xingrz/DeerMon-PCB/documents/ESP32-PICO-V3-02/SCH_ESP32-PICO-KIT-1_V1_0_20200811A.pdf

# ESP32

# Power Supply

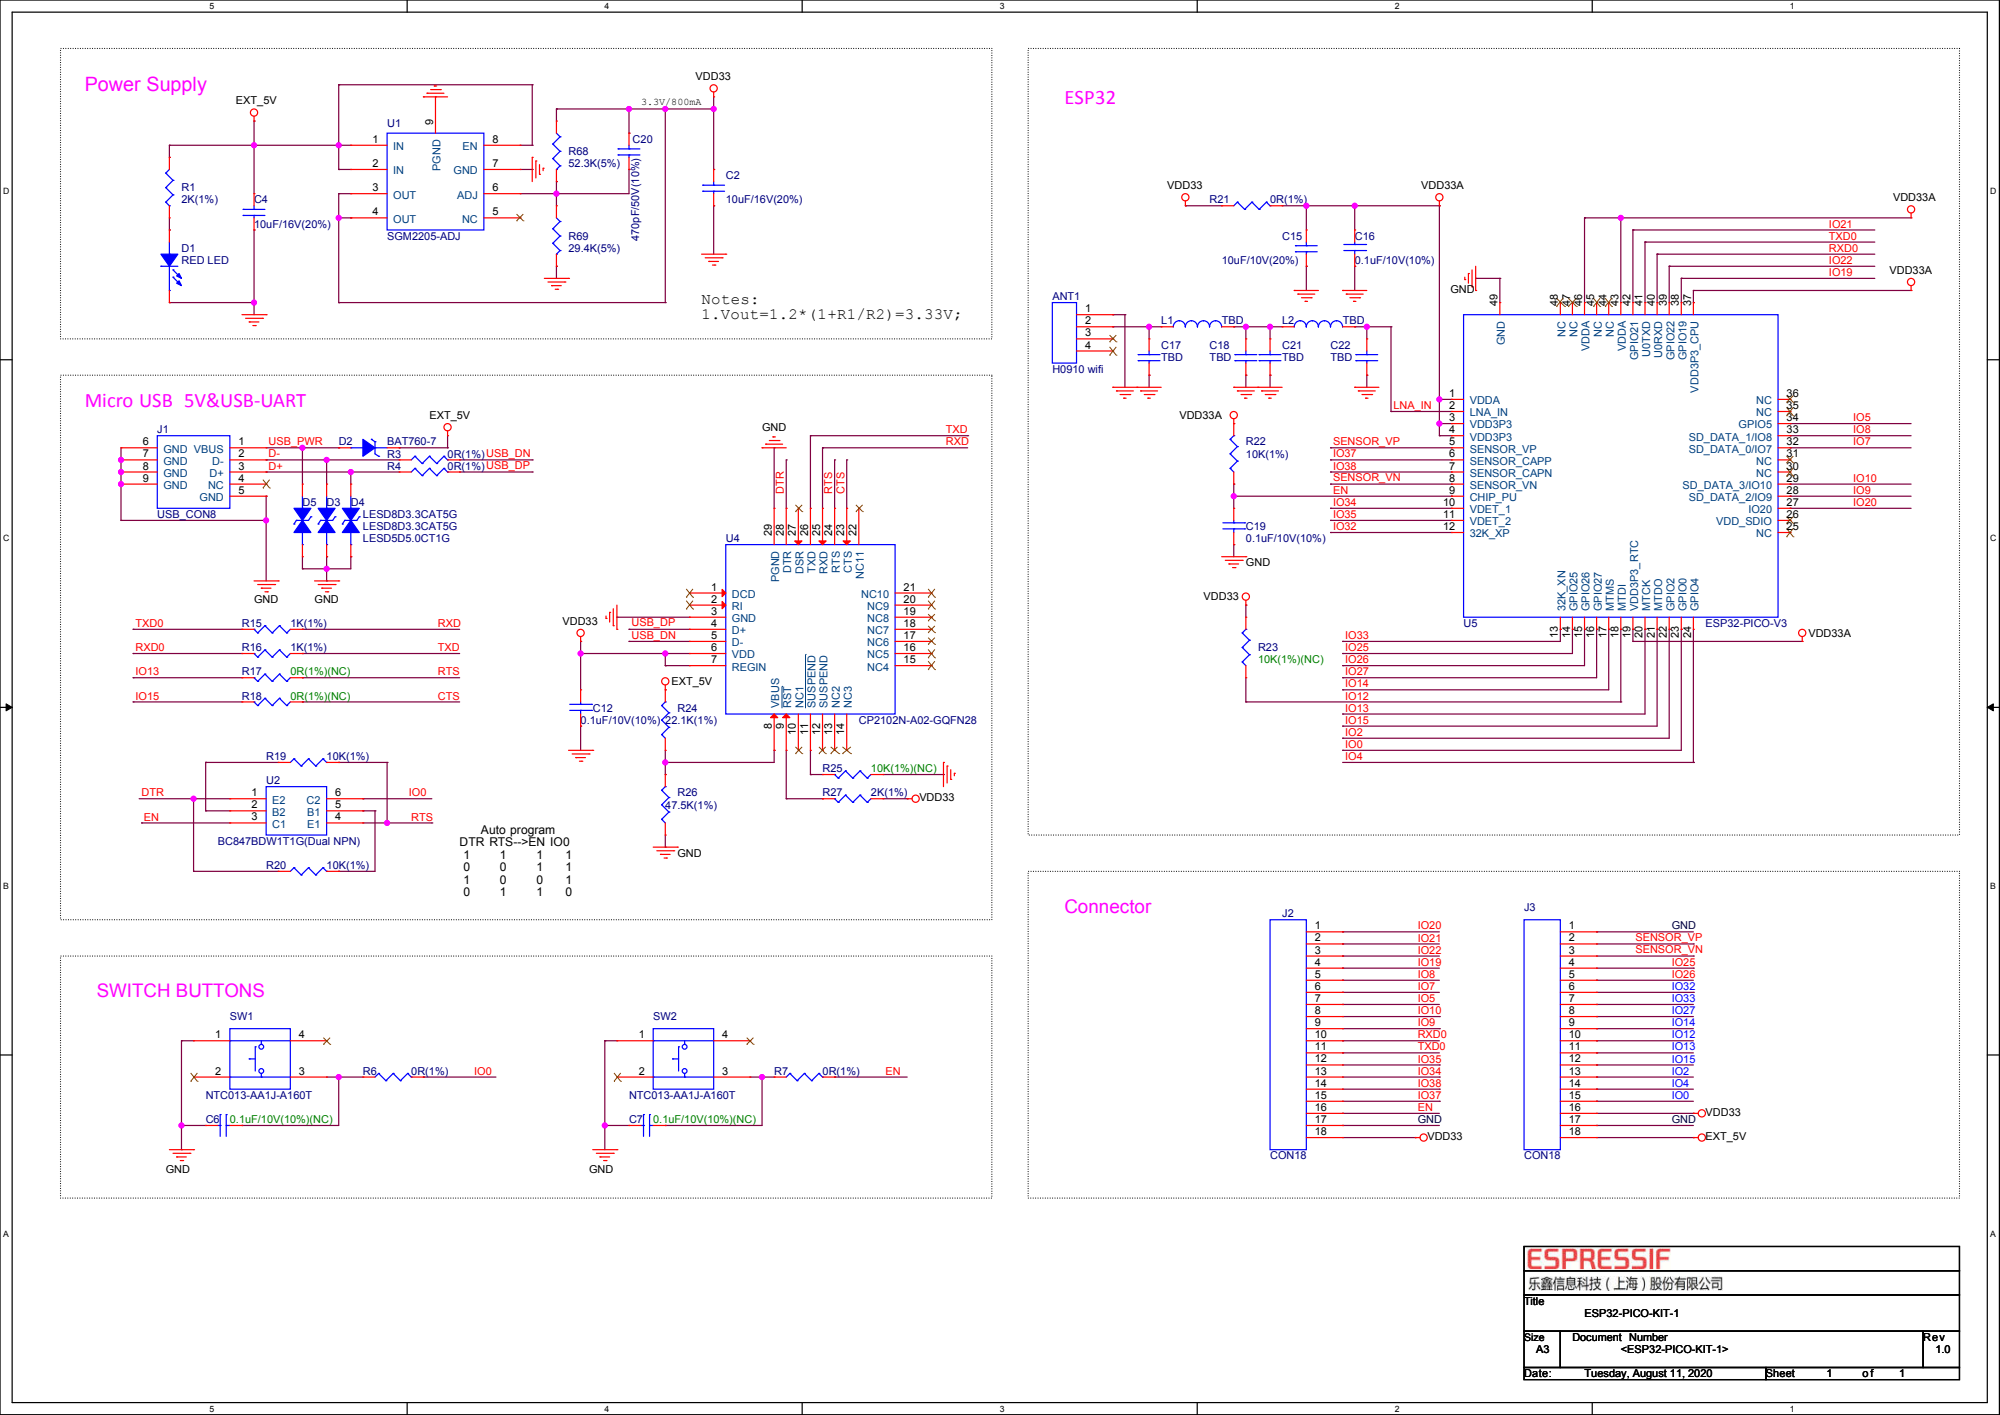
[picture p1: page 1]

Micro USB 5V&USB-UART
