xingrz/DeerMon-PCB/documents/ZJY144S025/1.44-SPI原理图.pdf

# 中景园电子1.44寸OLED显示屏模块原理图

# 淘宝地址：http://shop73023976.taobao.com/?spm=a1z10.1.0.0.byBTLt&v=1

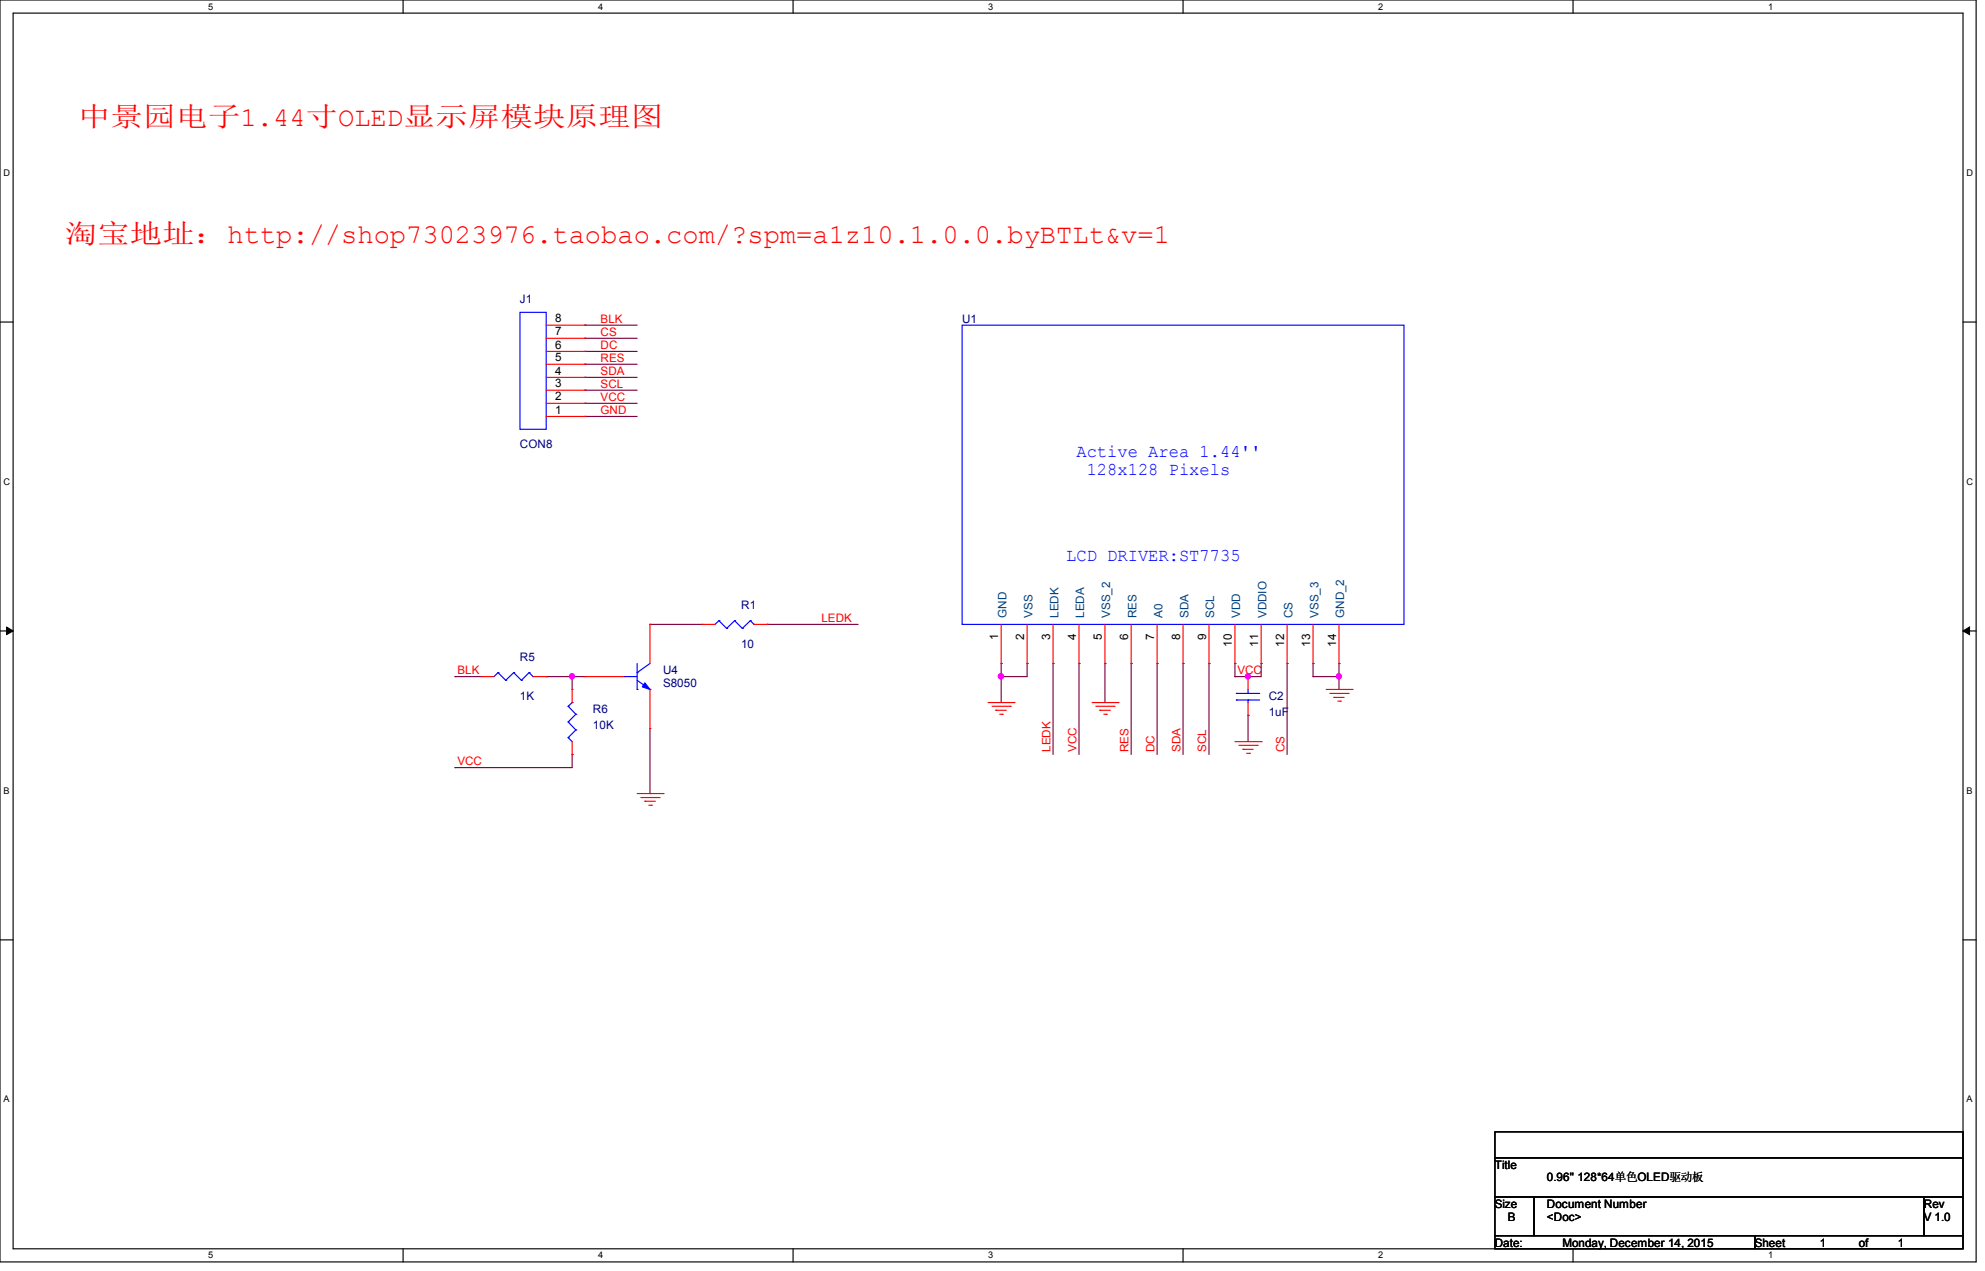
[picture p2: page 1]
CS DC RES SDA SCL VCC GND; LEDK; VCC; RES; SDA; SCL; BLK; Title; Size; Document Number; Rev; Date:; Sheet; <Doc>; 0.96'' 128*64单色OLED驱动板; Monday, December 14, 2015; LCD DRIVER:ST7735; Active Area 1.44'' 128x128 Pixels; GND 1; VSS 2; LEDK 3; LEDA 4; VSS_2 5; RES 6; SDA 8; SCL 9; VDD 10; VDDIO 11; VSS_3 13; GND_2 14; CON8
