xingrz/DeerMon-PCB/DeerMon-SCH.PDF

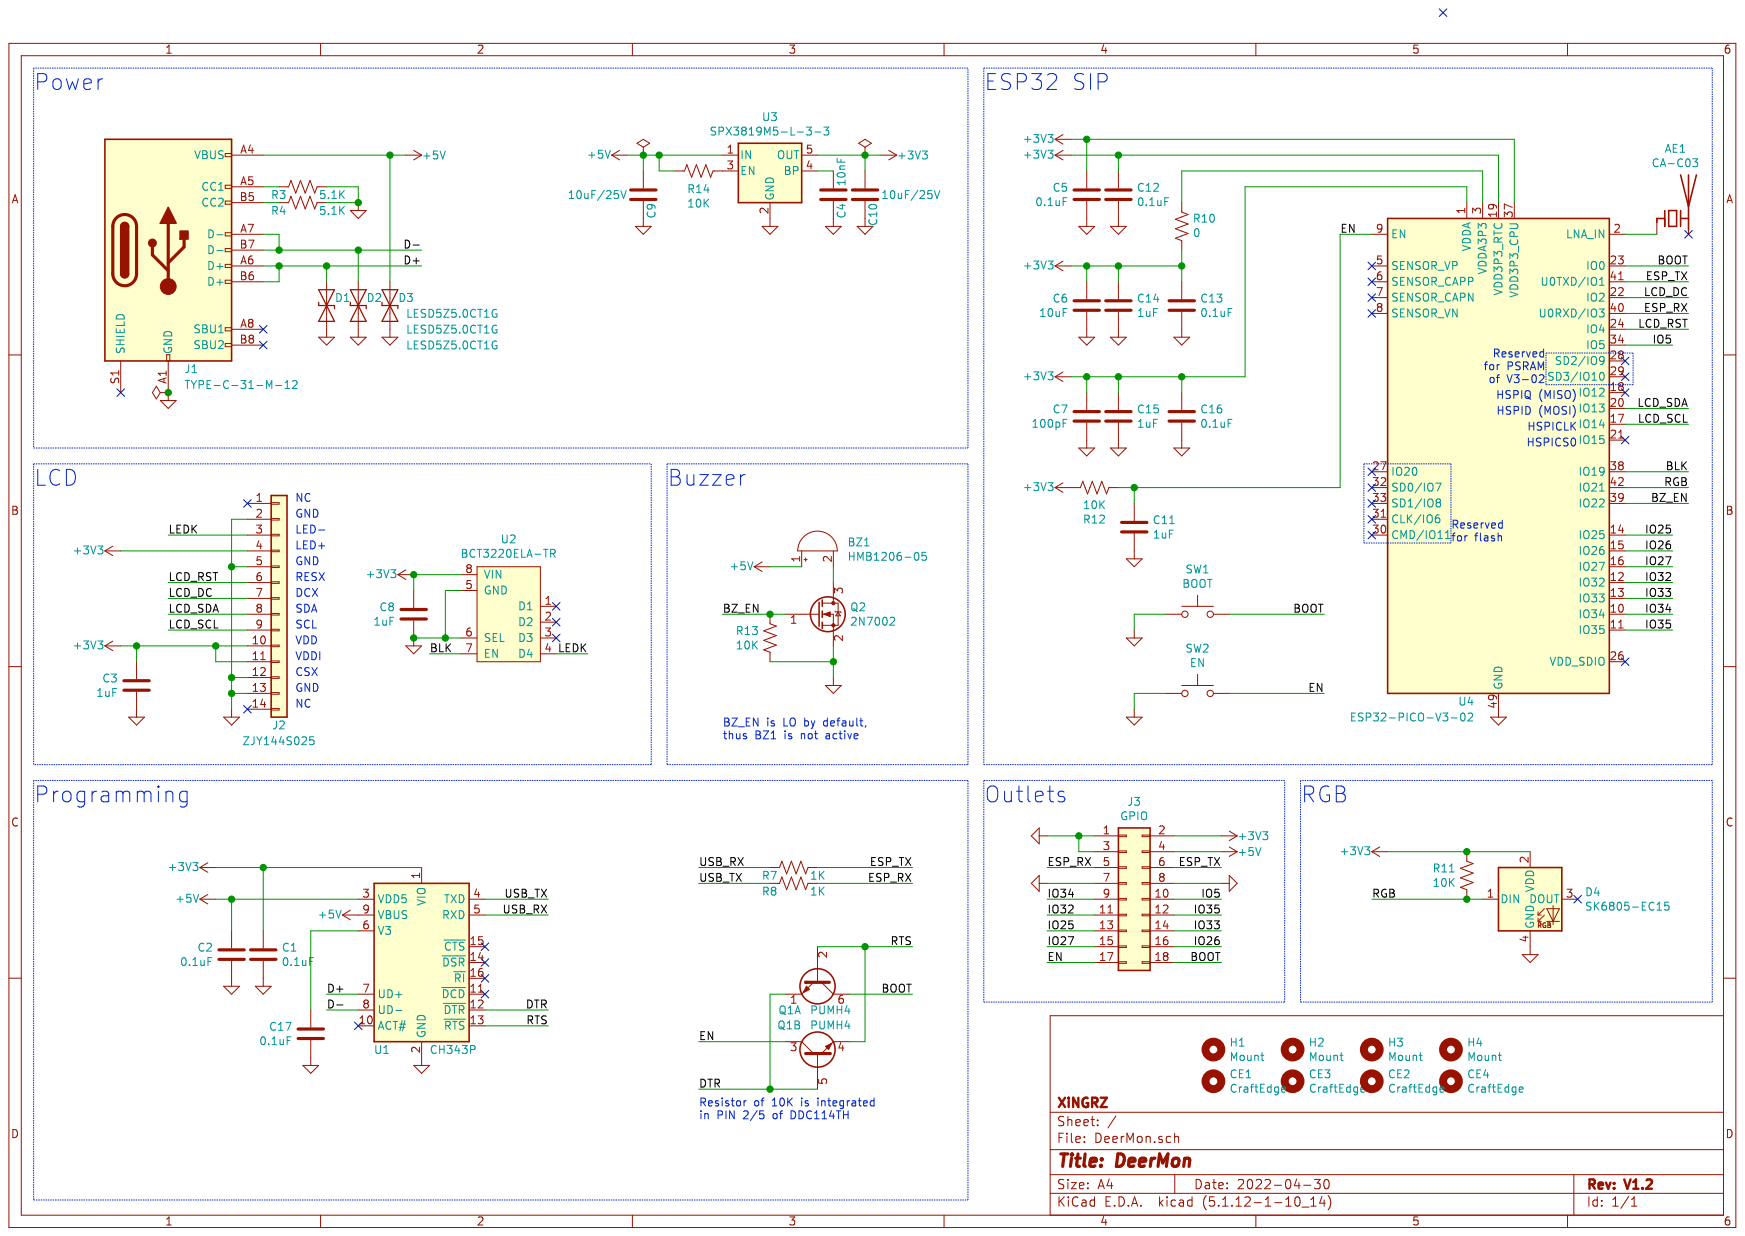
[picture p3: page 1]
