xingrz/DeerMon-PCB/DeerMon.kicad_pcb

## KiCad design DeerMon.kicad_pcb (2022-05-03)

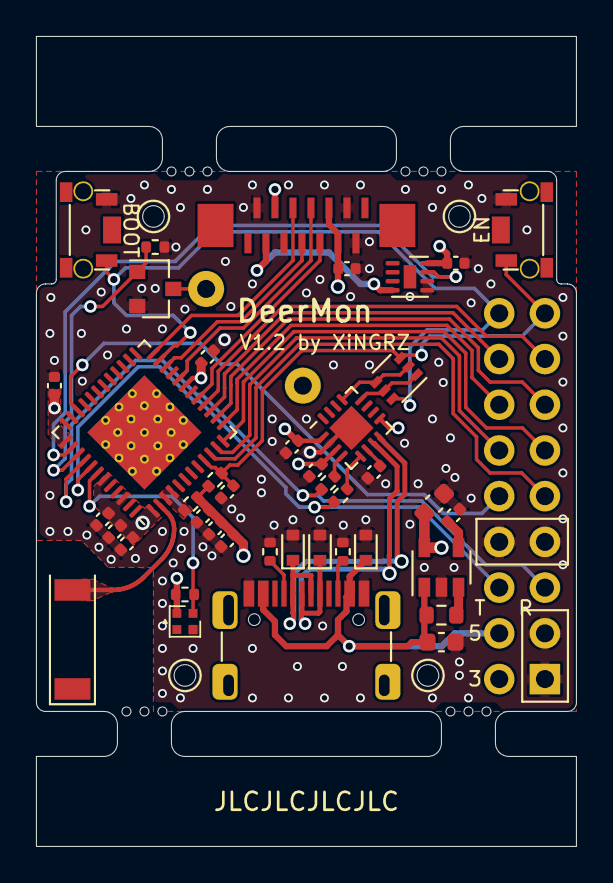
[picture p4: board DeerMon.kicad_pcb from above]

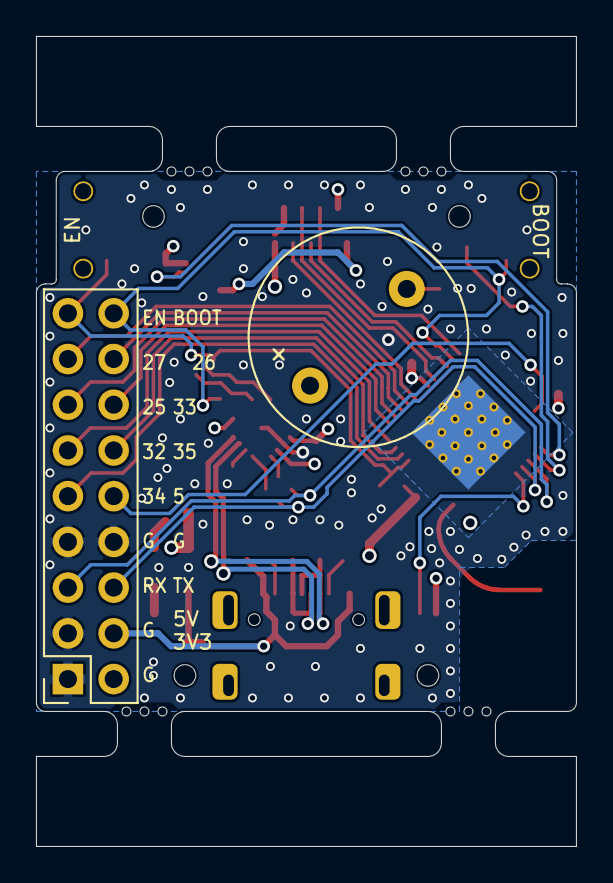
[picture p5: board DeerMon.kicad_pcb from below]

Board: 4 copper layers, 30.0 x 45.0 mm, 51 parts (2 on the bottom side), 37 nets.

Parts:
AE1: CA-C03; CrossAir_CA-C03
BZ1: HMB1206-05; HNDZ_TMB1206-05
C1, C2, C5, C12, C13, C16, C17: 0.1uF; C_0402_1005Metric
C3, C8, C11, C14, C15: 1uF; C_0402_1005Metric
C4: 10nF; C_0402_1005Metric
C6: 10uF; C_0402_1005Metric
C7: 100pF; C_0402_1005Metric
C9, C10: 10uF/25V; C_0603_1608Metric
CE1, CE2, CE3, CE4: CraftEdge; JLC_CRAFT_EDGE_3P
D1, D2, D3: LESD5Z5.0CT1G; D_SOD-523
D4: SK6805-EC15; OPSCO_SK68XX-EC15
H1, H2, H3, H4: Mount; MountingHole_1.2mm_M1
J1: TYPE-C-31-M-12; HRO_TYPE-C-31-M-12
J2: ZJY144S025; JS_AFC11-S14ICC-00
J3: GPIO; PinSocket_2x09_P2.54mm_Vertical
Q1: PUMH4; SOT-363_SC-70-6
Q2: 2N7002; SOT-23
R3, R4: 5.1K; R_0402_1005Metric
R7, R8: 1K; R_0402_1005Metric
R10: 0; R_0402_1005Metric
R11, R12, R13: 10K; R_0402_1005Metric
R14: 10K; R_0603_1608Metric
SW1: BOOT; SHOUHAN_TS24ZJ
SW2: EN; SHOUHAN_TS24ZJ
U1: CH343P; WQFN-16-1EP_3x3mm_P0.5mm_EP1.75x1.75mm
U2: BCT3220ELA-TR; DFN-8-1EP_2x2mm_P0.5mm_EP0.7x1.3mm
U3: SPX3819M5-L-3-3; SOT-23-5
U4: ESP32-PICO-V3-02; ESP32-PICO_QFN-48_7x7mm_P0.5mm_EP4.5x4.5mm_ThermalVias

Connections:
+3V3: C1.1, C3.1, C5.1, C6.1, C7.1, C8.1, C10.1, C12.1, C13.1, C14.1, C15.1, C16.1, D4.2, J2.4, J2.10, J2.11, J3.2, R10.1, R11.1, R12.1, U1.1, U2.8, U3.5, U4.1, U4.19, U4.37, U4.43, U4.46
+5V: BZ1.1, C2.1, C9.1, D3.1, J1.A4, J1.A9, J1.B4, J1.B9, J3.4, R14.2, U1.3, U1.9, U3.1
/BLK: U2.7, U4.38
/BOOT: J3.18, Q1.6, SW1.2, U4.23
/BZ_EN: Q2.1, R13.1, U4.39
/D+: D1.1, J1.A6, J1.B6, U1.7
/D-: D2.1, J1.A7, J1.B7, U1.8
/DTR: Q1.1, Q1.5, U1.12
/EN: C11.1, J3.17, Q1.3, R12.2, SW2.1, U4.9
/ESP_RX: J3.5, R8.1, U4.40
/ESP_TX: J3.6, R7.1, U4.41
/IO5: J3.10, U4.34
/IO25: J3.13, U4.14
/IO26: J3.16, U4.15
/IO27: J3.15, U4.16
/IO32: J3.11, U4.12
/IO33: J3.14, U4.13
/IO34: J3.9, U4.10
/IO35: J3.12, U4.11
/LCD_DC: J2.7, U4.22
/LCD_RST: J2.6, U4.24
/LCD_SCL: J2.9, U4.17
/LCD_SDA: J2.8, U4.20
/LEDK: J2.3, U2.4
/RGB: D4.1, R11.2, U4.42
/RTS: Q1.2, Q1.4, U1.13
/USB_RX: R7.2, U1.5
/USB_TX: R8.2, U1.4
GND: C1.2, C2.2, C3.2, C4.2, C5.2, C6.2, C7.2, C8.2, C9.2, C10.2, C11.2, C12.2, C13.2, C14.2, C15.2, C16.2, C17.2, D1.2, D2.2, D3.2, D4.4, J1.A1, J1.A12, J1.B1, J1.B12, J2.2, J2.5, J2.12, J2.13, J3.1, J3.3, J3.7, J3.8, Q2.2, R3.1, R4.1, R13.2, SW1.1, SW2.2, U1.2, U1.17, U2.5, U2.6, U3.2, U4.49
unnamed: AE1.1, U4.2
unnamed: BZ1.2, Q2.3
unnamed: C4.1, U3.4
unnamed: C17.1, U1.6
unnamed: J1.A5, R3.2
unnamed: J1.B5, R4.2
unnamed: R10.2, U4.3, U4.4
unnamed: R14.1, U3.3
