xingrz/DeerMon-PCB/(commit log)

2021-06-22 Done basic sch
    [cubicEarth.sch]
2021-06-22 Adjust pinout for ESP32-PICO-V3-02
    [cubicEarth.sch]
2021-06-22 Finish BOM
    [cubicEarth.sch]
2021-06-24 [WIP] PCB layout
    [cubicEarth.kicad_pcb, cubicEarth.sch]
2021-06-24 Use an SOT-563 dual NPN instead of 2 separated NPN
    [cubicEarth.kicad_pcb, cubicEarth.sch]
2021-06-24 Use LP2992AIM5X-3.3 instead of AMS1117-3.3
    [cubicEarth.kicad_pcb, cubicEarth.sch]
2021-06-25 PCB layout almost done
    [cubicEarth.kicad_pcb, cubicEarth.sch]
2021-06-25 Looks better
    [cubicEarth.kicad_pcb]
2021-06-26 Looks even better
    [cubicEarth.kicad_pcb]
2021-06-30 Add outline rulers
    [cubicEarth.kicad_pcb, cubicEarth.sch]
2022-02-20 Rename to DeerMon
    [DeerMon.sch, cubicEarth.kicad_pcb]
2022-02-20 Clean up
    [DeerMon.sch]
2022-02-20 Replace LP2992 with SPX3819
    [DeerMon.sch]
2022-02-20 Use 1.44" LCD, use PCB antenna
    [DeerMon.sch]
2022-02-22 Done schematic
    [DeerMon.sch]
2022-02-23 PCB layout
    [DeerMon.kicad_pcb, DeerMon.sch]
2022-02-23 Convert to 4 layers PCB
    [DeerMon.kicad_pcb]
2022-02-24 Update PCB layout
    [DeerMon.kicad_pcb, DeerMon.sch]
2022-02-25 Redraw power
    [DeerMon.kicad_pcb, DeerMon.sch]
2022-02-28 Finish PCB
    [DeerMon.kicad_pcb]
2022-02-28 Update BOM and documents
    [DeerMon.kicad_pcb, DeerMon.sch]
2022-02-28 Finish silk screen
    [DeerMon.kicad_pcb]
2022-02-28 Output manufacturing documents
    [DeerMon-Bottom_Cu.gbr, DeerMon-Bottom_Mask.gbr, DeerMon-Bottom_Paste.gbr, DeerMon-Bottom_Silk.gbr, DeerMon-EdgeCuts.gbr, DeerMon-NPTH.drl, DeerMon-PTH.drl, DeerMon-Top_Cu.gbr]
2022-03-03 Correct PCB thickness
    [DeerMon.kicad_pcb]
2022-03-03 Adjust outline for buttons
    [DeerMon.kicad_pcb]
2022-03-03 Update gerber
    [DeerMon-Bottom_Cu.gbr, DeerMon-Bottom_Mask.gbr, DeerMon-Bottom_Paste.gbr, DeerMon-Bottom_Silk.gbr, DeerMon-EdgeCuts.gbr, DeerMon-NPTH.drl, DeerMon-PTH.drl, DeerMon-Top_Cu.gbr]
2022-03-11 Add M1 mount points
    [DeerMon.kicad_pcb]
2022-03-23 Add craft edges and JLCJLCJLCJLC
    [DeerMon.kicad_pcb, DeerMon.sch]
2022-03-24 Fix BOM
    [DeerMon_BOM.csv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]
2022-03-24 Use mechanical drills instead of outline for mounting and positioning
    [DeerMon.kicad_pcb, DeerMon.sch]
2022-04-01 Use IO19/22 instead of reserved IO6/11 for BLK and BZ_EN
    [DeerMon.kicad_pcb, DeerMon.sch]
2022-04-01 Use DDC114TH instead of BC847BVC, with position of 10K resistor fixed
    [DeerMon.kicad_pcb, DeerMon.sch]
2022-04-04 Better tracks
    [DeerMon.kicad_pcb]
2022-04-04 Update silks
    [DeerMon.kicad_pcb]
2022-04-04 Update for RGB
    [DeerMon.kicad_pcb, DeerMon.sch]
2022-04-04 Drop position holes, let JLC add it
    [DeerMon.kicad_pcb]
2022-04-04 Better vias
    [DeerMon.kicad_pcb]
2022-04-06 Replace DDC114TH with PUMH4
    [DeerMon.kicad_pcb, DeerMon.sch]
2022-04-24 Replace AW9364 with BCT3220
    [DeerMon.kicad_pcb, DeerMon.sch]
2022-04-25 Use CH343P instead of CP2102N-A02-GQFN24R
    [DeerMon.kicad_pcb, DeerMon.sch]
2022-04-25 Better layout
    [DeerMon.kicad_pcb]
2022-04-26 Adjust craft edges and silks
    [DeerMon.kicad_pcb, DeerMon.sch]
2022-04-30 Update documents
    [DeerMon.kicad_pcb, DeerMon.sch]
2022-05-03 Correct package for SK6805-EC15
    [DeerMon.kicad_pcb, DeerMon.sch]
